iskyguy/Zigbee-ESP32-C6-USB-Dongle/case/images/lid-underside.png

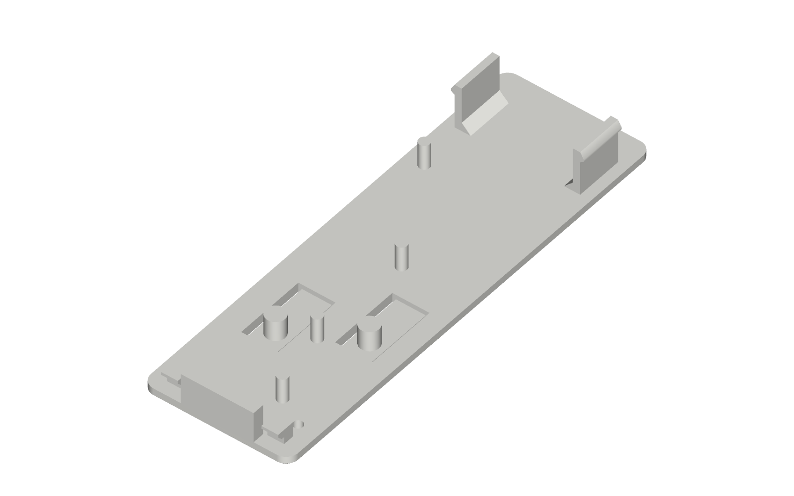
case/images/lid-underside.png
