iskyguy/Zigbee-ESP32-C6-USB-Dongle/case/images/open.png

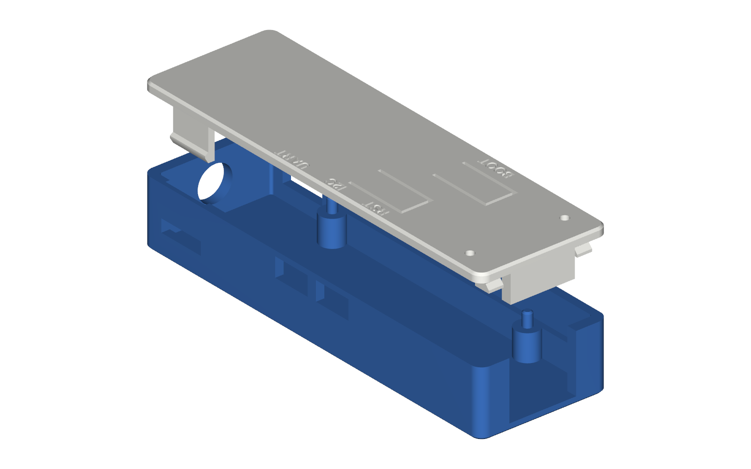
case/images/open.png
