iskyguy/Zigbee-ESP32-C6-USB-Dongle/hardware/zigbee-c6-dongle/production/bom.csv

Designator | Footprint | Quantity | Value | LCSC Part #
C1, C7 | 0603 | 2 | 0.1uF
C10 | 0603 | 1 | 0.47u
C2, C4 | 0805 | 2 | 22uF
C3 | 0603 | 1 | 1u
C5, C6 | 0603 | 2 | TBD
C8 | 0805 | 1 | 10u
C9 | 0603 | 1 | 0.1u
CR1 | SOT23-6L_STM-M | 1 | USBLC6-2SC6
D1, D2 | 0603 | 2 | LED
J1, J3 | CONN_SM04B-SRSS-TB_JST | 2 | SM04B-SRSS-TB
J2 | CUI_UP2-AH-1-TH | 1 | UP2-AH-1-TH | UP2-AH-1-TH
R1, R12, R2, R5, R6 | 0603 | 5 | 10k
R10, R11 | 0603 | 2 | 0
R13 | 0603 | 1 | 1k
R14 | 0603 | 1 | 2.2k
R3, R4 | 0603 | 2 | 22
R7, R8 | 0603 | 2 | 4.7k
R9 | 0603 | 1 | 499
SW2, SW3 | PTS526-G15_CNK | 2 | SW_Push
U1 | XCVR_ESP32-C6-MINI-1U-H4 | 1 | ESP32-C6-MINI-1U-H4 | ESP32-C6-MINI-1U-H4
U2 | CHIP_NSMF050_3P4XP18-M | 1 | MF-NSMF050-2
U3 | DBV0005A_M | 1 | AP2112K-3.3TRG1
U4 | SOIC14_SL_MCH-M | 1 | MCP2221A-I/SL
