iskyguy/Zigbee-ESP32-C6-USB-Dongle/case/dongle-case-lid.step

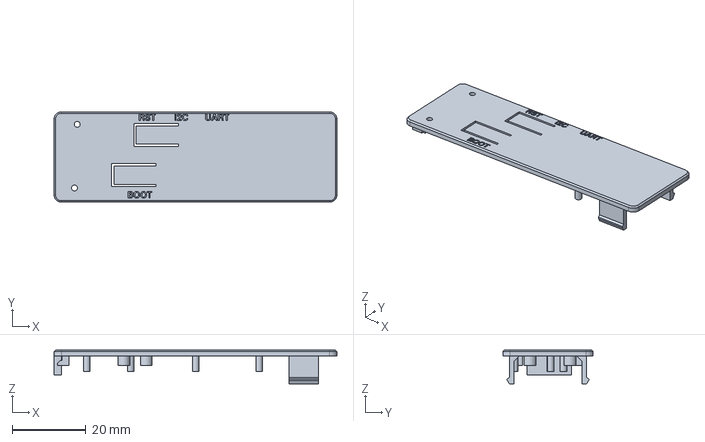
[picture p4: CAD file, 2026-11-11]
case/dongle-case-lid.step
76.8 x 24.5 x 9.20 mm
