iskyguy/Zigbee-ESP32-C6-USB-Dongle/documentation/assets/PTS526SMG15SMTR21_LFS/PTS526SMG15SMTR21_LFS.stp

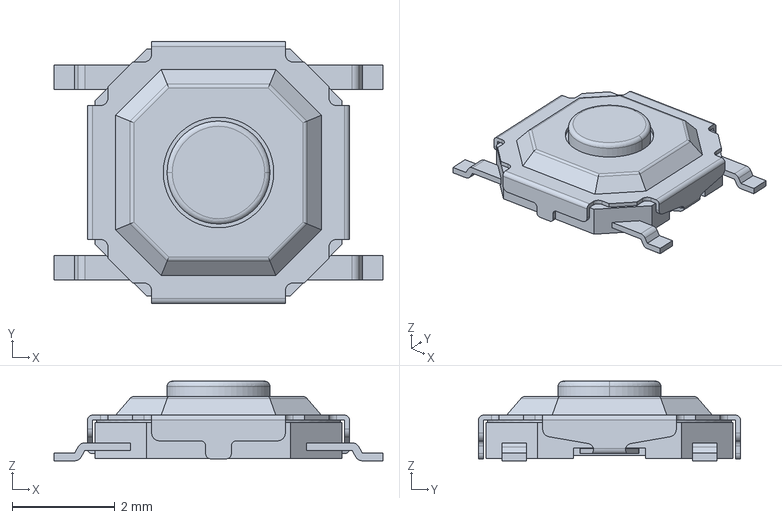
[picture p5: CAD file, 2026-11-11]
documentation/assets/PTS526SMG15SMTR21_LFS/PTS526SMG15SMTR21_LFS.stp
6.40 x 5.10 x 1.55 mm
