iskyguy/Zigbee-ESP32-C6-USB-Dongle/case/dongle-case-base.step

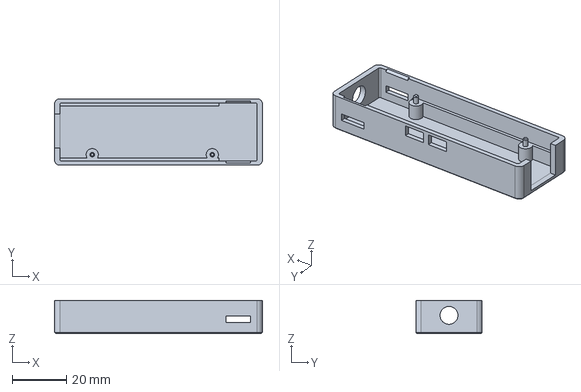
[picture p6: CAD file, 2026-11-11]
case/dongle-case-base.step
76.8 x 24.5 x 12.2 mm
