iskyguy/Zigbee-ESP32-C6-USB-Dongle/(list of files, cad)

Other CAD files:
case/dongle-case-base.stl
case/dongle-case-lid.stl
