iskyguy/Zigbee-ESP32-C6-USB-Dongle/documentation/exports/review/plots/zigbee-c6-dongle_20261110_1018.pdf

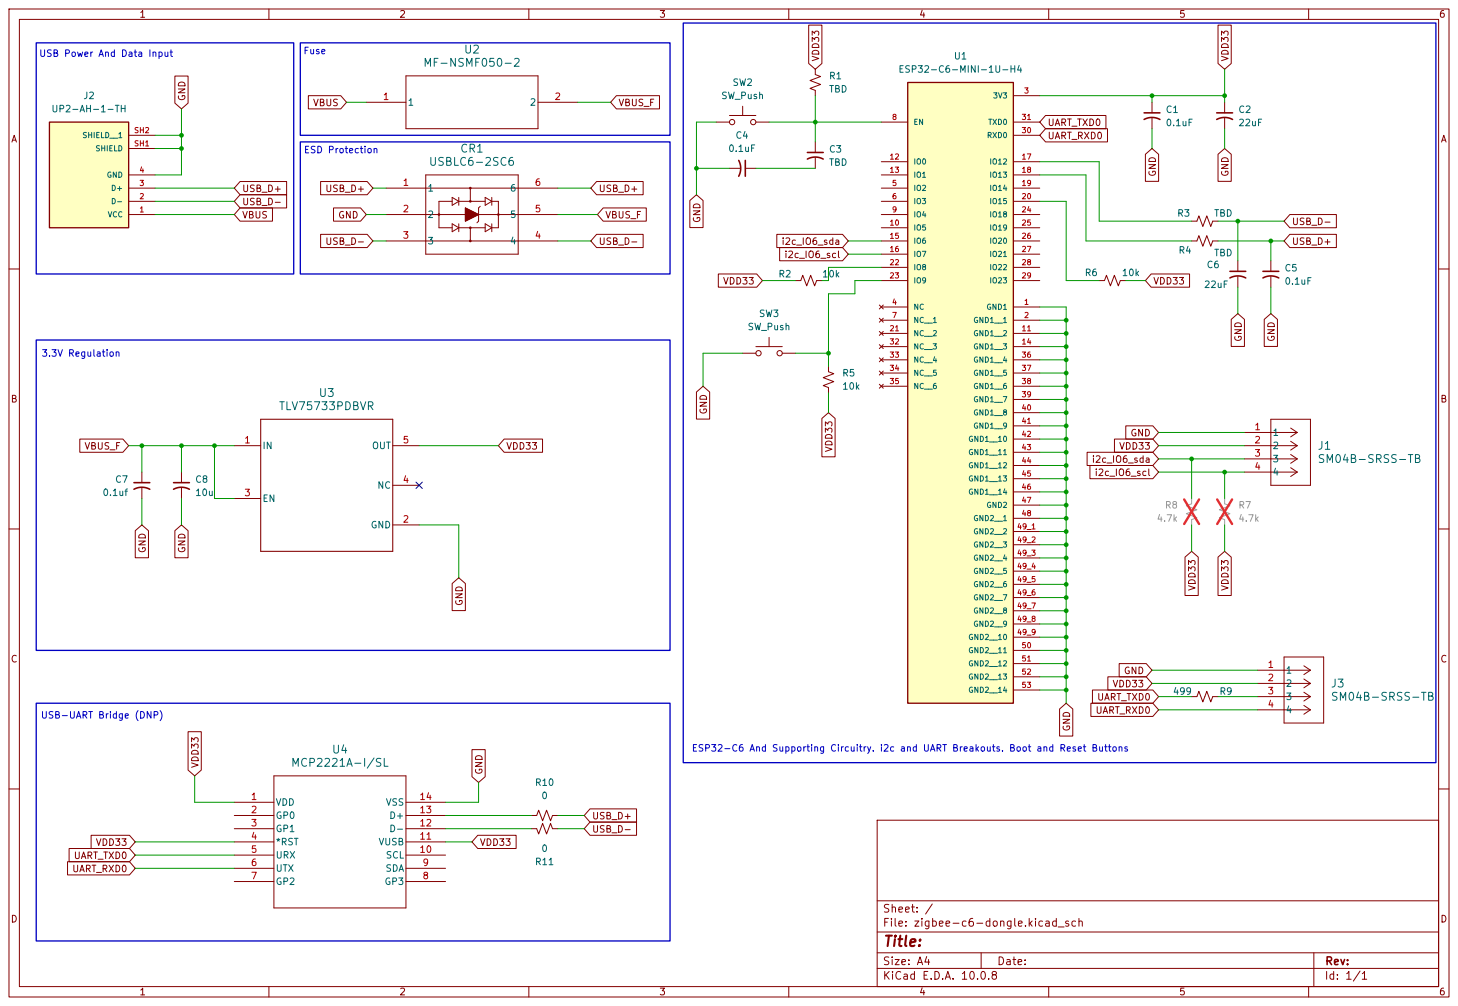
[picture p7: page 1]

ESP32-C6 And Supporting Circuitry. i2c and UART Breakouts. Boot and Reset Buttons 3.3V Regulation USB Power And Data Input USB-UART Bridge (DNP)

Size: A4 | Rev:
KiCad E.D.A. 10.0.8 | Id: 1/1
