iskyguy/Zigbee-ESP32-C6-USB-Dongle/documentation/exports/review/plots/zigbee-c6-dongle_20261110_1034.pdf

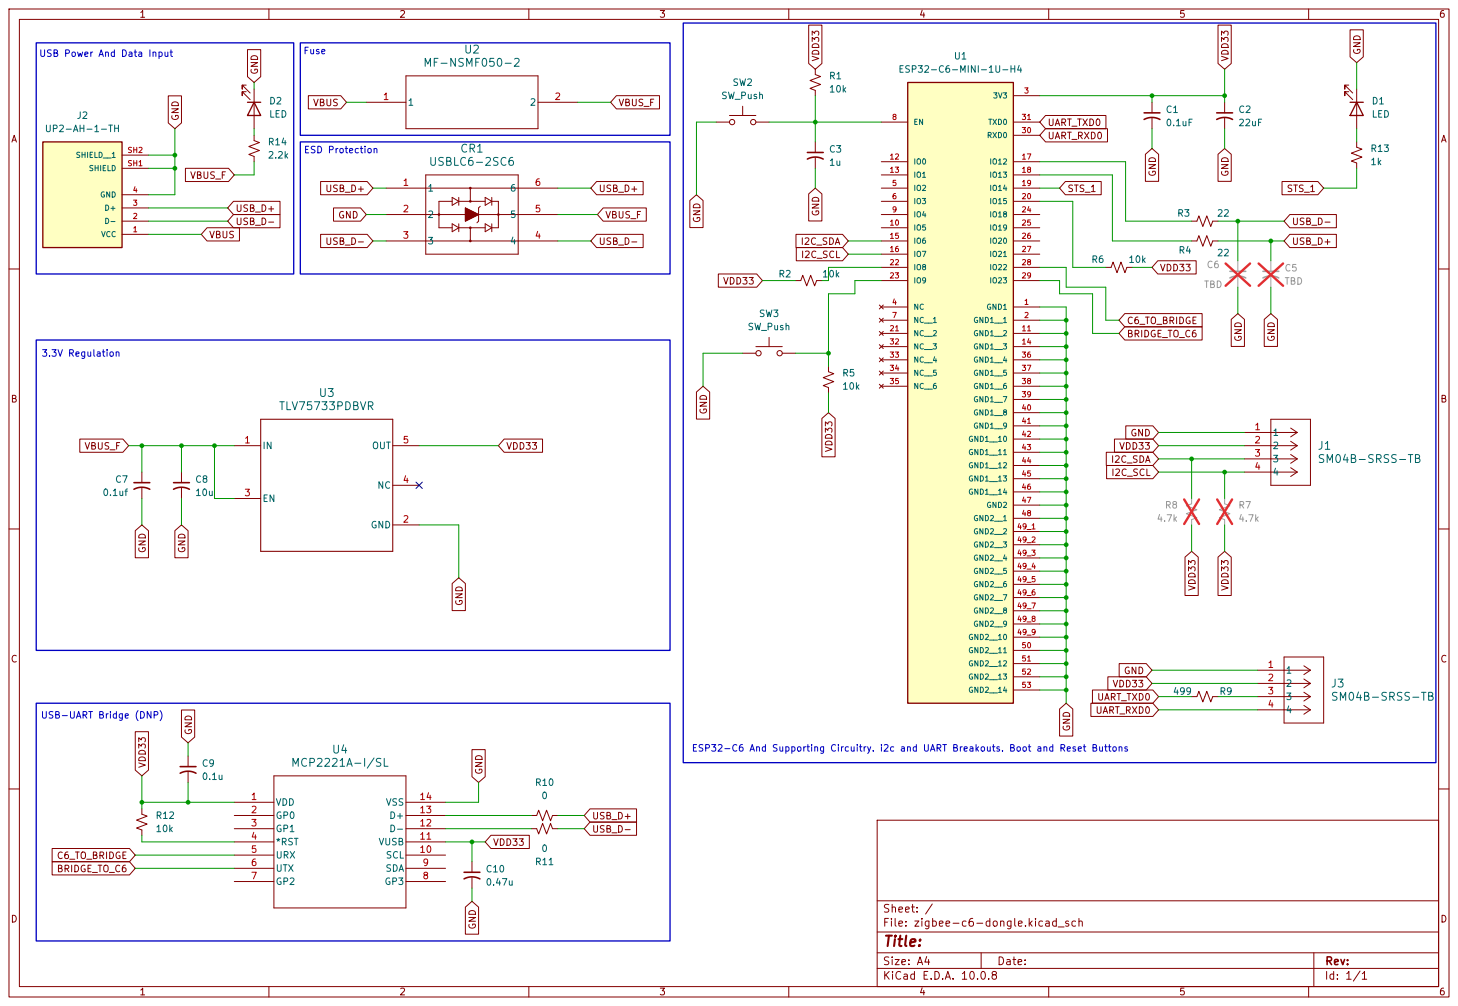
[picture p8: page 1]

Fuse ESD Protection USB Power And Data Input USB-UART Bridge (DNP) 3.3V Regulation

ESP32-C6 And Supporting Circuitry. i2c and UART Breakouts. Boot and Reset Buttons

Size: A4 | Rev:
KiCad E.D.A. 10.0.8 | Id: 1/1
