iskyguy/Zigbee-ESP32-C6-USB-Dongle/documentation/exports/review/plots/zigbee-c6-dongle_20261110_1139_PCB/zigbee-c6-dongle-F_Cu.pdf

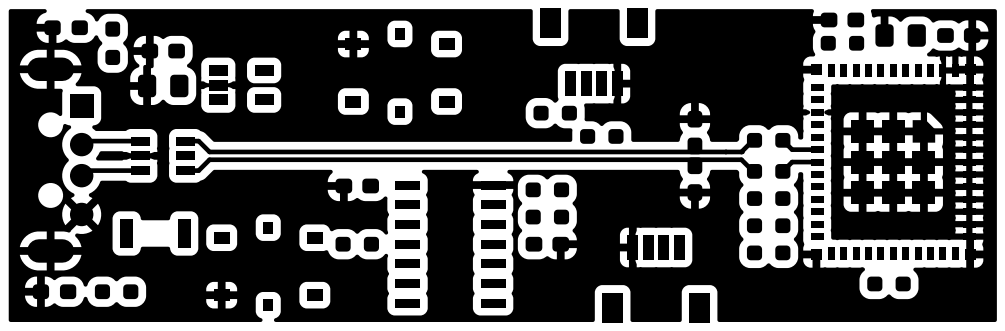
[picture p12: page 1]
