iskyguy/Zigbee-ESP32-C6-USB-Dongle/documentation/exports/review/plots/zigbee-c6-dongle_20261110_1217_PCB/zigbee-c6-dongle-B_Cu.pdf

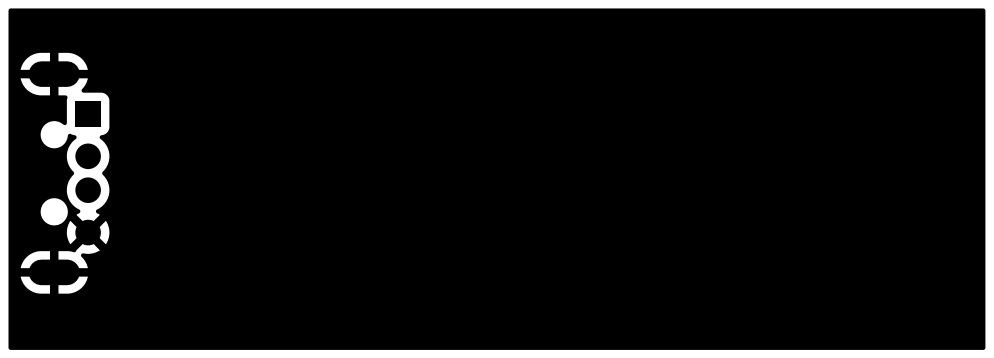
[picture p17: page 1]
