iskyguy/Zigbee-ESP32-C6-USB-Dongle/hardware/zigbee-c6-dongle/zigbee-c6-dongle.kicad_pcb

## KiCad design hardware/zigbee-c6-dongle/zigbee-c6-dongle.kicad_pcb (2026-11-11)

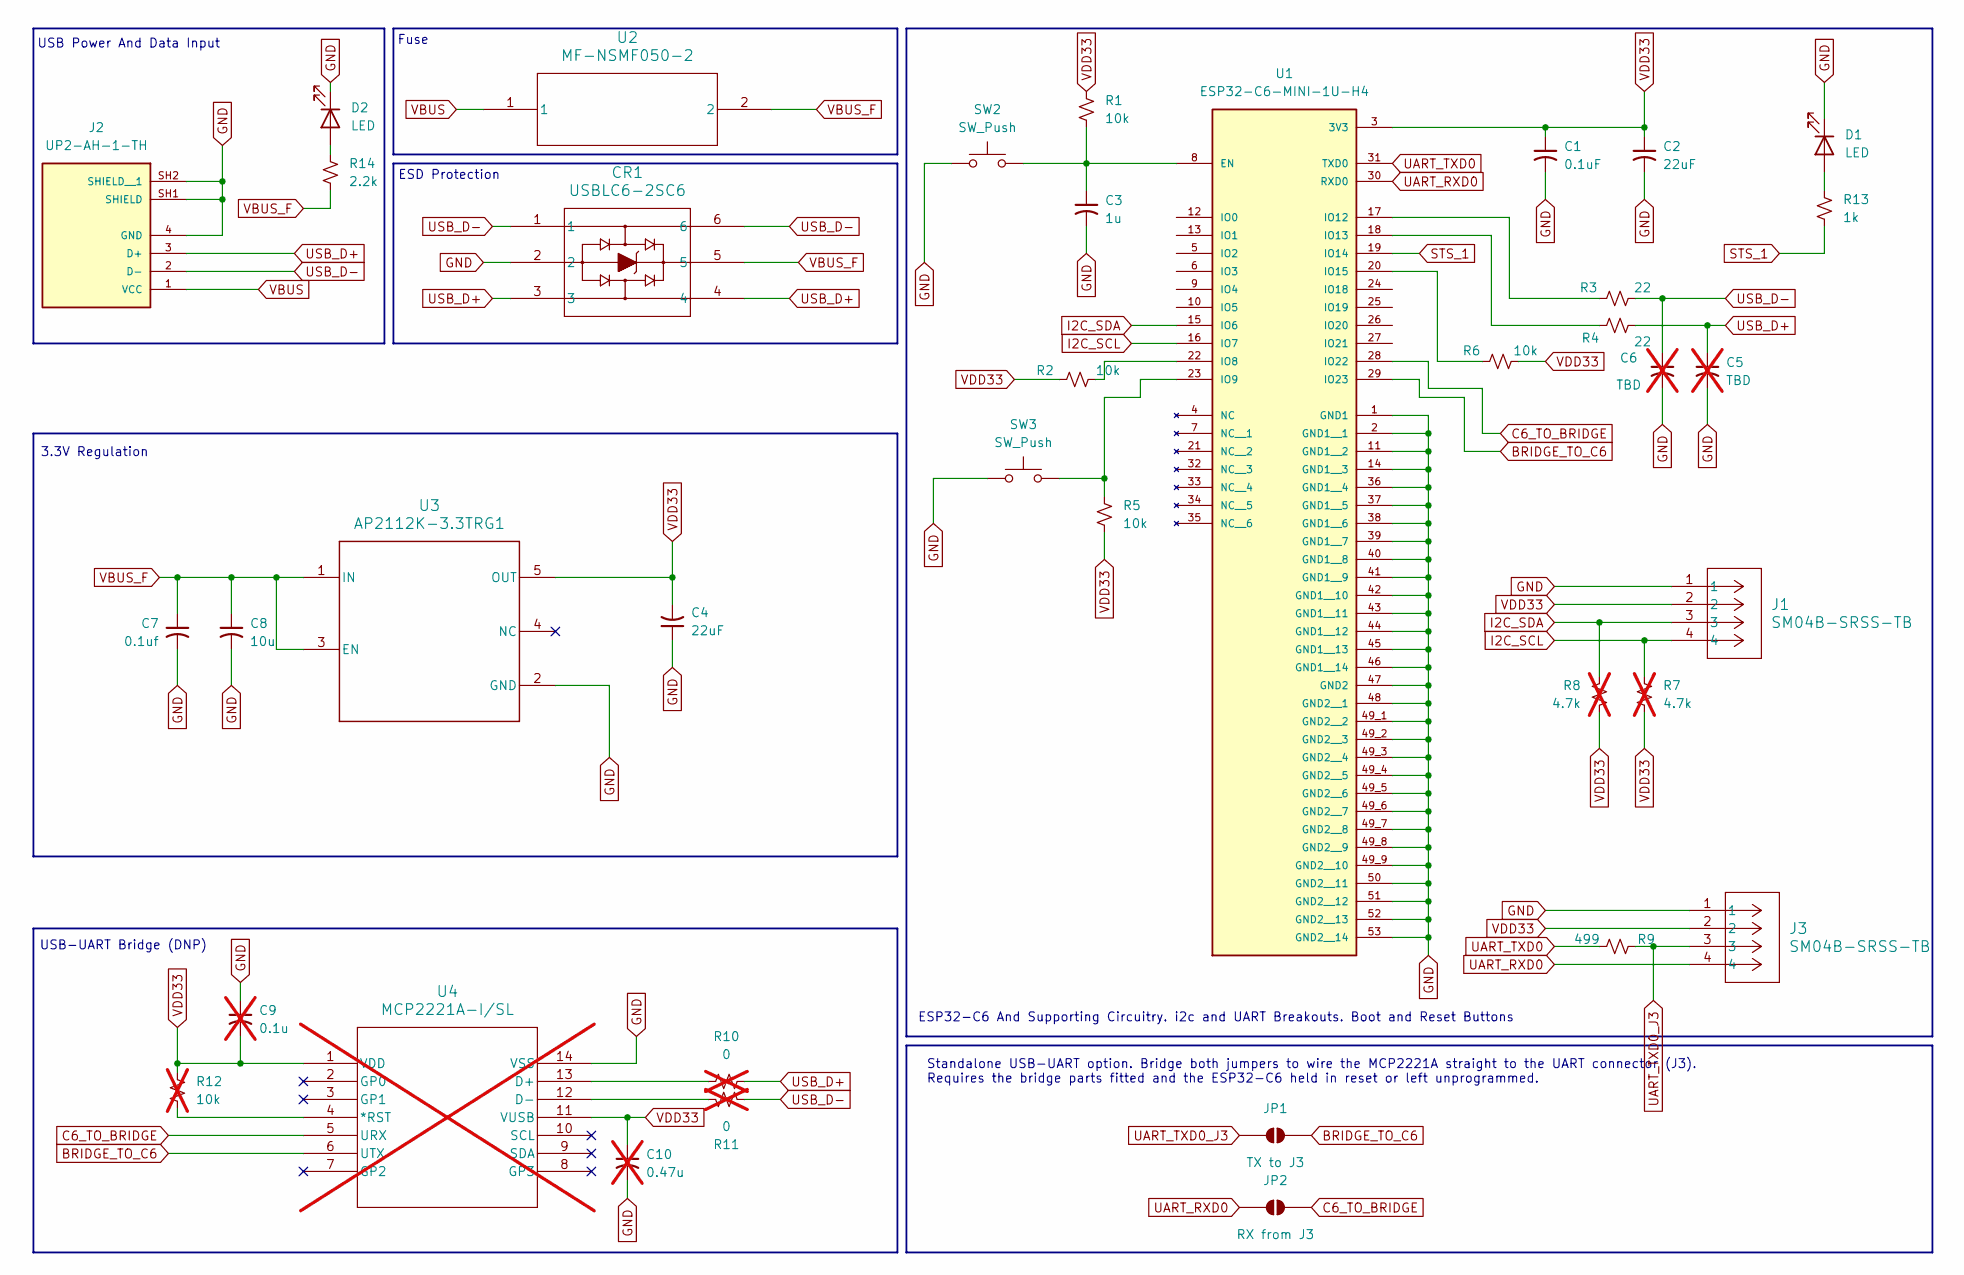
[picture p24: schematic zigbee-c6-dongle.kicad_sch, Zigbee C6 Dongle]

Parts:
C1: 0.1uF; C_0603_1608Metric_Pad1.08x0.95mm_HandSolder
C2, C4: 22uF; C_0805_2012Metric_Pad1.18x1.45mm_HandSolder
C3: 1u; C_0603_1608Metric_Pad1.08x0.95mm_HandSolder
C5, C6: TBD; C_0603_1608Metric_Pad1.08x0.95mm_HandSolder; not fitted
C7: 0.1uf; C_0603_1608Metric_Pad1.08x0.95mm_HandSolder
C8: 10u; C_0805_2012Metric_Pad1.18x1.45mm_HandSolder
C9: 0.1u; C_0603_1608Metric_Pad1.08x0.95mm_HandSolder; not fitted
C10: 0.47u; C_0603_1608Metric_Pad1.08x0.95mm_HandSolder; not fitted
CR1: USBLC6-2SC6; SOT23-6L_STM-M
D1, D2: LED; LED_0603_1608Metric_Pad1.05x0.95mm_HandSolder
J1, J3: SM04B-SRSS-TB; CONN_SM04B-SRSS-TB_JST
J2: UP2-AH-1-TH; CUI_UP2-AH-1-TH; MPN UP2-AH-1-TH
JP1: TX to J3; SolderJumper-2_P1.3mm_Open_Pad1.0x1.5mm
JP2: RX from J3; SolderJumper-2_P1.3mm_Open_Pad1.0x1.5mm
R1, R2, R5, R6: 10k; R_0603_1608Metric_Pad0.98x0.95mm_HandSolder
R3, R4: 22; R_0603_1608Metric_Pad0.98x0.95mm_HandSolder
R7, R8: 4.7k; R_0603_1608Metric_Pad0.98x0.95mm_HandSolder; not fitted
R9: 499; R_0603_1608Metric_Pad0.98x0.95mm_HandSolder
R10, R11: 0; R_0603_1608Metric_Pad0.98x0.95mm_HandSolder; not fitted
R12: 10k; R_0603_1608Metric_Pad0.98x0.95mm_HandSolder; not fitted
R13: 1k; R_0603_1608Metric_Pad0.98x0.95mm_HandSolder
R14: 2.2k; R_0603_1608Metric_Pad0.98x0.95mm_HandSolder
SW2, SW3: SW_Push; PTS526-G15_CNK
U1: ESP32-C6-MINI-1U-H4; XCVR_ESP32-C6-MINI-1U-H4; MPN ESP32-C6-MINI-1U-H4
U2: MF-NSMF050-2; CHIP_NSMF050_3P4XP18-M
U3: AP2112K-3.3TRG1; DBV0005A_M
U4: MCP2221A-I/SL; SOIC14_SL_MCH-M; not fitted

Connections:
BRIDGE_TO_C6: JP1.2 (B), U1.29 (IO23), U4.6 (UTX)
C6_TO_BRIDGE: JP2.2 (B), U1.28 (IO22), U4.5 (URX)
GND: C1.2, C2.2, C3.2, C4.1, C5.2, C6.2, C7.2, C8.2, C9.1, C10.2, CR1.2, D1.1 (K), D2.1 (K), J1.1, J2.4 (GND), J2.SH1 (SHIELD), J2.SH2 (SHIELD__1), J3.1, SW2.1, SW3.2, U1.1 (GND1), U1.2 (GND1__1), U1.11 (GND1__2), U1.14 (GND1__3), U1.36 (GND1__4), U1.37 (GND1__5), U1.38 (GND1__6), U1.39 (GND1__7), U1.40 (GND1__8), U1.41 (GND1__9), U1.42 (GND1__10), U1.43 (GND1__11), U1.44 (GND1__12), U1.45 (GND1__13), U1.46 (GND1__14), U1.47 (GND2), U1.48 (GND2__1), U1.49_1 (GND2__2), U1.49_2 (GND2__3), U1.49_3 (GND2__4), U1.49_4 (GND2__5), U1.49_5 (GND2__6), U1.49_6 (GND2__7), U1.49_7 (GND2__8), U1.49_8 (GND2__9), U1.49_9 (GND2__10), U1.50 (GND2__11), U1.51 (GND2__12), U1.52 (GND2__13), U1.53 (GND2__14), U3.2 (GND), U4.14 (VSS)
I2C_SCL: J1.4, R7.1, U1.16 (IO7)
I2C_SDA: J1.3, R8.1, U1.15 (IO6)
unnamed: D1.2 (A), R13.1
unnamed: D2.2 (A), R14.1
unnamed: C3.1, R1.2, SW2.2, U1.8 (EN)
unnamed: R2.2, U1.22 (IO8)
unnamed: R5.2, SW3.1, U1.23 (IO9)
unnamed: R3.1, U1.17 (IO12)
unnamed: R4.1, U1.18 (IO13)
unnamed: R6.1, U1.20 (IO15)
unnamed: R12.1, U4.4 (*RST)
unnamed: R10.1, U4.13 (D+)
unnamed: R11.1, U4.12 (D-)
STS_1: R13.2, U1.19 (IO14)
UART_RXD0: J3.4, JP2.1 (A), U1.30 (RXD0)
UART_TXD0: R9.2, U1.31 (TXD0)
UART_TXD0_J3: J3.3, JP1.1 (A), R9.1
USB_D+: C5.1, CR1.3, CR1.4, J2.3 (D+), R4.2, R10.2
USB_D-: C6.1, CR1.1, CR1.6, J2.2 (D-), R3.2, R11.2
VBUS: J2.1 (VCC), U2.1
VBUS_F: C7.1, C8.1, CR1.5, R14.2, U2.2, U3.1 (IN), U3.3 (EN)
VDD33: C1.1, C2.1, C4.2, C9.2, C10.1, J1.2, J3.2, R1.1, R2.1, R5.1, R6.2, R7.2, R8.2, R12.2, U1.3 (3V3), U3.5 (OUT), U4.1 (VDD), U4.11 (VUSB)

Notes on the sheet:
ESD Protection
Fuse
ESP32-C6 And Supporting Circuitry. i2c and UART Breakouts. Boot and Reset Buttons
USB Power And Data Input
USB-UART Bridge (DNP)
3.3V Regulation
Standalone USB-UART option. Bridge both jumpers to wire the MCP2221A straight to the UART connector (J3). Requires the bridge parts fitted and the ESP32-C6 held in reset or left unprogrammed.

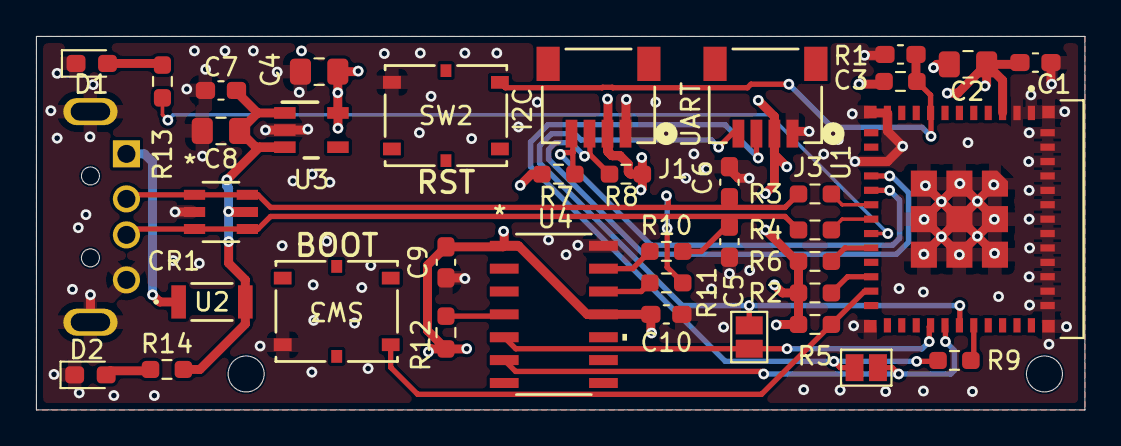
[picture p25: board zigbee-c6-dongle.kicad_pcb from above]

Board: 4 copper layers, 58.2 x 20.8 mm, 40 parts (1 on the bottom side), 25 nets.

Other parts of the board:
H1, H2: IndexHole_2mm; MountingHole_2mm
